thebgfan/3d-models/spool-holder/spacer.stl

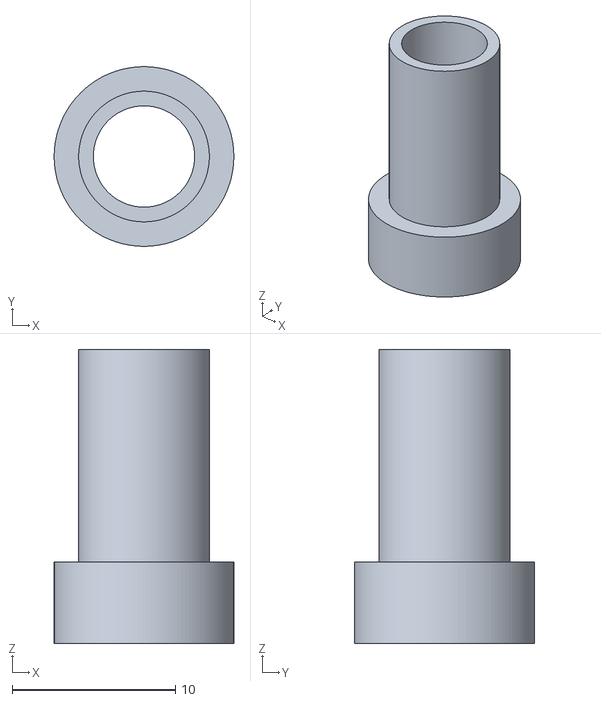
[picture p4: CAD file, 2022-06-03]
spool-holder/spacer.stl
11.0 x 11.0 x 18.0
