thebgfan/3d-models/spool-holder/base.stl

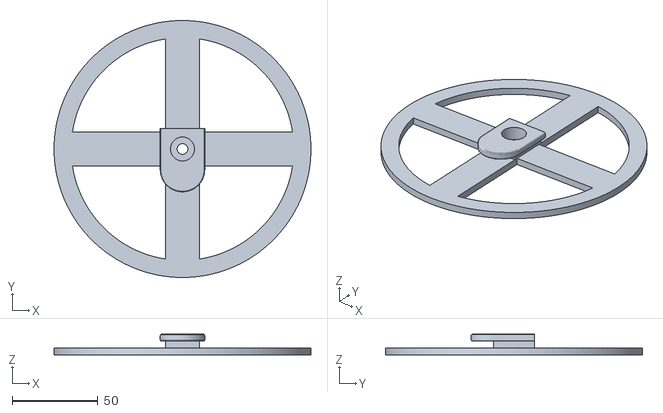
[picture p5: CAD file, 2022-06-03]
spool-holder/base.stl
150.0 x 150.0 x 12.0
