thebgfan/3d-models/spool-holder/spindle.stl

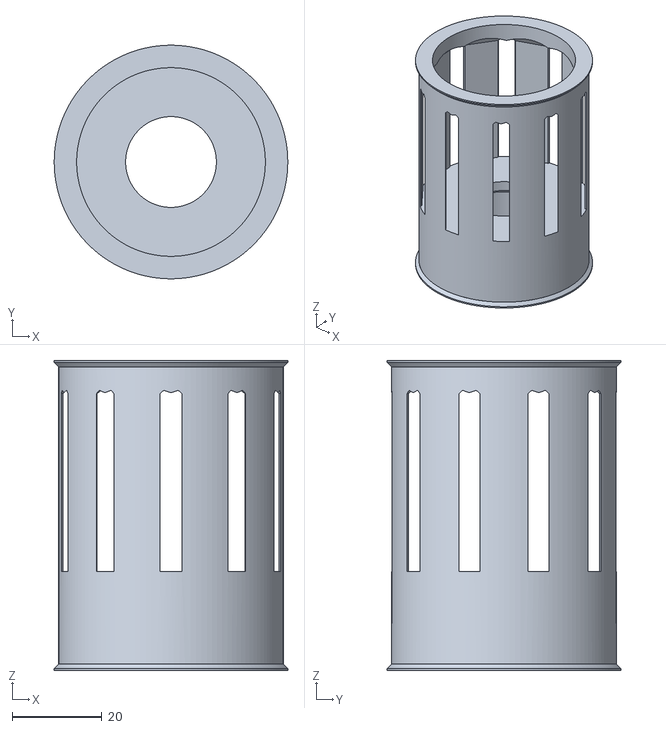
[picture p6: CAD file, 2022-06-03]
spool-holder/spindle.stl
52.0 x 52.0 x 69.0
